ReneSpanl/GridFrequency/PCB/IsolationBarrier/Anlage/BotView.png

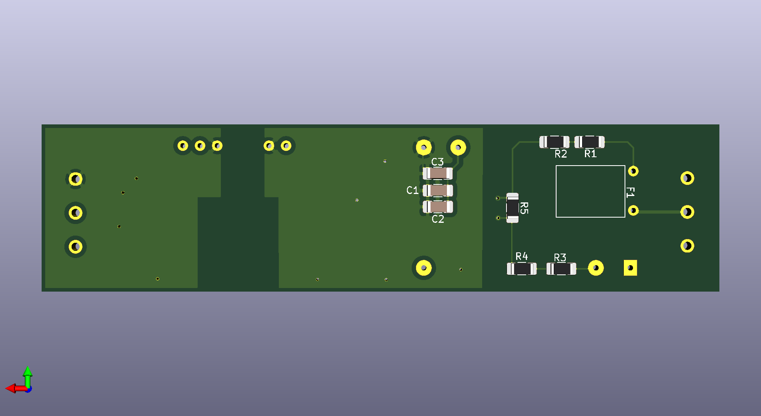
PCB/IsolationBarrier/Anlage/BotView.png
