ReneSpanl/GridFrequency/PCB/IsolationBarrier/Anlage/TopView.png

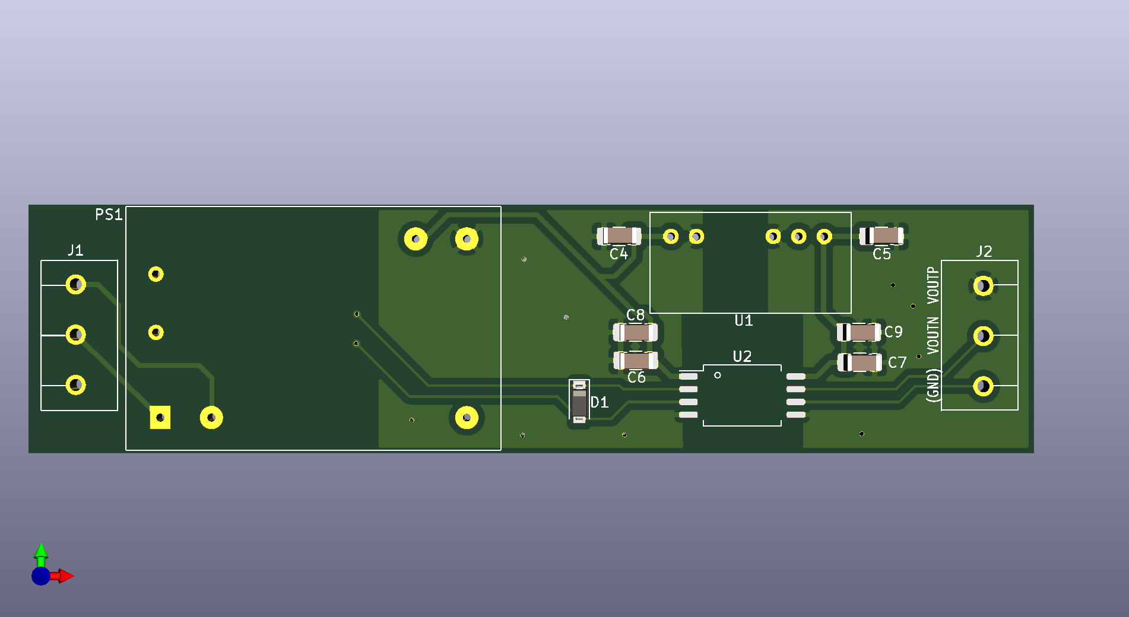
PCB/IsolationBarrier/Anlage/TopView.png
