ReneSpanl/GridFrequency/Messwerterfassung_Messproblem_DT9816.pdf

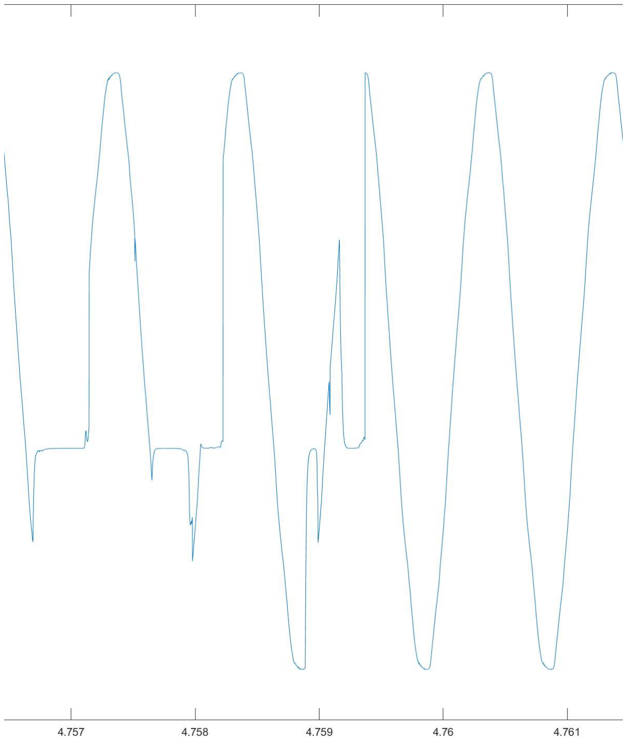
[picture p3: page 1]
