ReneSpanl/GridFrequency/PCB/PCB.csv

Reference | Quantity | Value | Footprint | Datasheet
AE1 | 1 | SMB Antenna | Frequenzmessung PCB:Molex_SMB_0731000103 | https://www.digikey.de/product-detail/de/molex/0731000103/WM5523-ND/1465145
C1 C7 C8 C18 C17 C30 C25 C36 C40 | 9 | 100nF | Capacitor_SMD:C_1206_3216Metric_Pad1.42x1.75mm_HandSolder | https://www.digikey.de/product-detail/de/samsung-electro-mechanics/CL31B104KBCNFNC/1276-2744-1-ND/3890830
C11 C19 C15 C2 C37 | 5 | 10nF | Capacitor_SMD:C_1206_3216Metric_Pad1.42x1.75mm_HandSolder | https://www.digikey.de/product-detail/de/samsung-electro-mechanics/CL31B103KBCNNNC/1276-1035-1-ND/3889121
C13 | 1 | 11nF | Capacitor_SMD:C_1206_3216Metric_Pad1.42x1.75mm_HandSolder | https://www.digikey.de/product-detail/de/murata-electronics/GRM3195C1H113JA01D/490-1755-1-ND/587572
C16 | 1 | 20.5nF | Capacitor_SMD:C_1206_3216Metric_Pad1.42x1.75mm_HandSolder | https://www.digikey.de/product-detail/de/murata-electronics/GRM3195C1H203JA01D/490-1760-1-ND/587546
C22 | 1 | 154nF | Capacitor_SMD:C_1206_3216Metric_Pad1.42x1.75mm_HandSolder | https://www.digikey.de/product-detail/de/yageo/CC1206JKX7R9BB154/311-4385-1-ND/8025474
C3 C14 | 2 | 2200uF | Capacitor_SMD:CP_Elec_10x10.5 | https://www.digikey.de/product-detail/de/panasonic-electronic-components/EEE-FT1A152AP/P15083CT-ND/2796924
C4 C12 | 2 | 100uF | Capacitor_SMD:C_1206_3216Metric_Pad1.42x1.75mm_HandSolder | https://www.digikey.de/product-detail/de/taiyo-yuden/JMK316ABJ107ML-T/587-3395-1-ND/4157508
C5 C10 C29 C23 C27 C24 C34 C38 C32 C31 | 10 | 10uF | Capacitor_SMD:C_1206_3216Metric_Pad1.42x1.75mm_HandSolder | https://www.digikey.de/product-detail/de/samsung-electro-mechanics/CL21A106KOQNNWE/1276-2894-1-ND/3890980
C6 C9 C21 C20 C26 C28 C35 C39 C33 | 9 | 1uF | Capacitor_SMD:C_1206_3216Metric_Pad1.42x1.75mm_HandSolder | https://www.digikey.de/product-detail/de/samsung-electro-mechanics/CL31B105KAHNNNE/1276-1097-1-ND/3889183
D2 D1 | 2 | 5V | Diode_SMD:D_SOD-323_HandSoldering | https://www.digikey.de/product-detail/de/diodes-incorporated/MMSZ5232BS-7-F/MMSZ5232BS-FDICT-ND/815868
J1 | 1 | USB_B_Micro | DigiKey Footprints:USB_Micro_B_Female_10118194-0001LF | https://www.digikey.de/product-detail/de/amphenol-icc-fci/10118194-0001LF/609-4618-2-ND/2785389
J2 | 1 | 6P6C | Frequenzmessung PCB:6P6C | https://www.digikey.de/product-detail/de/pulse-electronics-network/E5566-Q0LK22-L/553-2258-ND/1785239
J3 | 1 | Raspberry_Pi_2_3 | Connector_PinSocket_2.54mm:PinSocket_2x20_P2.54mm_Vertical | https://www.digikey.de/product-detail/de/samtec-inc/ESQ-120-23-T-D/SAM9315-ND/6678052
L1 | 1 | 27nH | Inductor_SMD:L_1206_3216Metric_Pad1.42x1.75mm_HandSolder | https://www.digikey.de/product-detail/de/tdk-corporation/NLV32T-027J-EF/445-16534-1-ND/4766575
R1 R2 | 2 | 27 | Resistor_SMD:R_1206_3216Metric_Pad1.42x1.75mm_HandSolder | https://www.digikey.de/product-detail/de/stackpole-electronics-inc/RMCF1206JT27R0/RMCF1206JT27R0CT-ND/2418899
R10 | 1 | 5.9k | Resistor_SMD:R_1206_3216Metric_Pad1.42x1.75mm_HandSolder | https://www.digikey.de/product-detail/de/koa-speer-electronics-inc/RK73H2BTTD5901F/2019-RK73H2BTTD5901FCT-ND/10237182
R11 | 1 | 3.16k | Resistor_SMD:R_1206_3216Metric_Pad1.42x1.75mm_HandSolder | https://www.digikey.de/product-detail/de/rohm-semiconductor/MCR18ERTF3161/RHM3-16KCJCT-ND/4085566
R13 | 1 | 1.13k | Resistor_SMD:R_1206_3216Metric_Pad1.42x1.75mm_HandSolder | https://www.digikey.de/product-detail/de/rohm-semiconductor/MCR18ERTF1131/RHM1-13KCJCT-ND/4085288
R14 | 1 | 1.62k | Resistor_SMD:R_1206_3216Metric_Pad1.42x1.75mm_HandSolder | https://www.digikey.de/product-detail/de/stackpole-electronics-inc/RMCF1206FT1K62/RMCF1206FT1K62CT-ND/2418617
R17 R16 | 2 | 390k | Resistor_SMD:R_1206_3216Metric_Pad1.42x1.75mm_HandSolder | https://www.digikey.de/product-detail/de/stackpole-electronics-inc/RMCF1206FT390K/RMCF1206FT390KCT-ND/2418725
R18 R15 | 2 | 52.3k | Resistor_SMD:R_1206_3216Metric_Pad1.42x1.75mm_HandSolder | https://www.digikey.de/product-detail/de/koa-speer-electronics-inc/RK73H2BTTD5232F/2019-RK73H2BTTD5232FCT-ND/10237717
R19 | 1 | 1k | Resistor_SMD:R_1206_3216Metric_Pad1.42x1.75mm_HandSolder | https://www.digikey.de/product-detail/de/stackpole-electronics-inc/RMCF1206JT1K00/RMCF1206JT1K00CT-ND/1942786
R20 | 1 | 0 | Resistor_SMD:R_1206_3216Metric_Pad1.42x1.75mm_HandSolder | https://www.digikey.de/product-detail/de/stackpole-electronics-inc/RMCF1206ZT0R00/RMCF1206ZT0R00CT-ND/1942835
R3 R21 | 2 | 10k | Resistor_SMD:R_1206_3216Metric_Pad1.42x1.75mm_HandSolder | https://www.digikey.de/product-detail/de/stackpole-electronics-inc/RMCF1206JT10K0/RMCF1206JT10K0CT-ND/1942803
R4 | 1 | 10 | Resistor_SMD:R_1206_3216Metric_Pad1.42x1.75mm_HandSolder | https://www.digikey.de/product-detail/de/stackpole-electronics-inc/RMCF1206JG10R0/RMCF1206JG10R0CT-ND/6053279
R5 R6 | 2 | 5k | Resistor_SMD:R_1206_3216Metric_Pad1.42x1.75mm_HandSolder | https://www.digikey.de/product-detail/de/yageo/RT1206BRD075KL/YAG5090CT-ND/6617246
R8 R12 | 2 | 4.32k | Resistor_SMD:R_1206_3216Metric_Pad1.42x1.75mm_HandSolder | https://www.digikey.de/product-detail/de/stackpole-electronics-inc/RMCF1206FT4K32/RMCF1206FT4K32CT-ND/1942695
R9 R7 | 2 | 22.5k | Resistor_SMD:R_1206_3216Metric_Pad1.42x1.75mm_HandSolder | https://www.digikey.de/product-detail/de/koa-speer-electronics-inc/RK73H2BTTD2262F/2019-RK73H2BTTD2262FCT-ND/10237879
SW1 | 1 | SW_DIP_x01 | Button_Switch_SMD:SW_DIP_SPSTx01_Slide_9.78x4.72mm_W8.61mm_P2.54mm | https://www.digikey.de/product-detail/de/cui-devices/DS04-254-1-01BK-SMT/2223-DS04-254-1-01BK-SMT-ND/11310893
TP2 TP1 TP7 TP6 TP8 TP9 TP4 TP3 TP5 | 9 | TestPoint | Connector_PinHeader_2.54mm:PinHeader_1x01_P2.54mm_Vertical | schon vorhanden
U1 | 1 | NEO-M8M | RF_GPS:ublox_NEO | schon vorhanden
U2 | 1 | LM2902 | Frequenzmessung PCB:LM2902_14_pin | schon vorhanden
U3 | 1 | LTC3265 | Frequenzmessung PCB:LTC3265 | schon vorhanden
U4 | 1 | ADS868X | Package_SO:SSOP-16_4.4x5.2mm_P0.65mm | schon vorhanden
