ReneSpanl/GridFrequency/PCB/BOM.xlsx

Für Peripherie
1x | Solderpaste |  | https://www.digikey.de/product-detail/de/chip-quik-inc/SMD291AX50T3/SMD291AX50T3-ND/5130159
1x | Raspberry Pi 4 |  | https://www.reichelt.de/raspberry-pi-4-b-4x-1-5-ghz-2-gb-ram-wlan-bt-rasp-pi-4-b-2gb-p259919.html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
1x | Netzteil usb c |  | https://www.reichelt.de/raspberry-pi-netzteil-5-1-v-3-0-a-usb-type-c-eu-stecker-s-rpi-ps-15w-bk-eu-p260010.html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
1x | microHDMI zu HDMI |  | https://www.reichelt.de/raspberry-pi-adapter-micro-hdmi-auf-hdmi-2m-schwarz-rpi-m-hdmi-hdmi4-p275440.html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
1x | MicroSD |  | https://www.reichelt.de/microsdxc-speicherkarte-128gb-sandisk-extreme-pro-sdsqxcy128ggn6ma-p262419.html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
1x | ESD Bürste |  | https://www.reichelt.de/esd-reinigungsbuerste-pinsel-6-7-cm-quad-1903ec075-p292923.html?trstct=pos_11&nbc=1
1x | Glasfaserradierer |  | https://www.reichelt.de/sg/de/glasradierer-glasfaserpinsel-radierer-glas-p53404.html?trstct=pos_0&nbc=1
Bauelemente:
Analog front end |  |  |  | IsolationsPCB
5x | 6P6C Conn. | https://www.digikey.de/product-detail/de/pulse-electronics-network/E5566-Q0LK22-L/553-2258-ND/1785239 |  | 10x | 22uF | https://www.digikey.de/product-detail/de/samsung-electro-mechanics/CL31A226MOCLNNC/1276-2728-1-ND/3890814
2x | Pi 40Pin | https://www.digikey.de/product-detail/de/samtec-inc/ESQ-120-23-T-D/SAM9315-ND/6678052 |  | 50x | 100nF | https://www.digikey.de/product-detail/de/samsung-electro-mechanics/CL31B104KBCNFNC/1276-2744-1-ND/3890830
2x | SMB | https://www.digikey.de/product-detail/de/molex/0731000103/WM5523-ND/1465145 |  | 20x | 1uF | https://www.digikey.de/product-detail/de/samsung-electro-mechanics/CL31B105KAHNNNE/1276-1097-1-ND/3889183
50x | 100nF | https://www.digikey.de/product-detail/de/samsung-electro-mechanics/CL31B104KBCNFNC/1276-2744-1-ND/3890830 |  | 20x | 10u | https://www.digikey.de/product-detail/de/samsung-electro-mechanics/CL31B106KAHNNNE/1276-1804-1-ND/3889890
50x | 10nF | https://www.digikey.de/product-detail/de/samsung-electro-mechanics/CL31B103KBCNNNC/1276-1035-1-ND/3889121 |  | 10x | TVS | https://www.digikey.de/product-detail/de/rohm-semiconductor/RSA5MGTR/846-RSA5MGCT-ND/2331732
10x | 11nF | https://www.digikey.de/product-detail/de/murata-electronics/GRM3195C1H113JA01D/490-1755-1-ND/587572 |  | 5x | Fuse | https://www.digikey.de/product-detail/de/littelfuse-inc/LVR005NS/LVR005NS-ND/1853845
10x | 20.5nF | https://www.digikey.de/product-detail/de/murata-electronics/GRM3195C1H203JA01D/490-1760-1-ND/587546 |  | 5x | IEC Conn. | https://www.digikey.de/product-detail/de/schurter-inc/4300-0103/486-4132-ND/8299834
10x | 154nF | https://www.digikey.de/product-detail/de/yageo/CC1206JKX7R9BB154/311-4385-1-ND/8025474 |  | 5x | 6P6C Conn. | https://www.digikey.de/product-detail/de/pulse-electronics-network/E5566-Q0LK22-L/553-2258-ND/1785239
10x | 1500uF | https://www.digikey.de/product-detail/de/panasonic-electronic-components/EEE-FT1A152AP/P15083CT-ND/2796924 |  | 100x | 82k R | https://www.digikey.de/product-detail/de/te-connectivity-passive-product/CRGP1206F82K/A130561CT-ND/8578393
20x | 100uF | https://www.digikey.de/product-detail/de/taiyo-yuden/JMK316ABJ107ML-T/587-3395-1-ND/4157508 |  | 10x | 200 R | https://www.digikey.de/product-detail/de/panasonic-electronic-components/ERA-8AEB201V/P200BCCT-ND/3069644
100x | 10uF | https://www.digikey.de/product-detail/de/samsung-electro-mechanics/CL21A106KOQNNWE/1276-2894-1-ND/3890980 |  | 100x | 8,2k R | https://www.digikey.de/product-detail/de/koa-speer-electronics-inc/RK73H2BTTD8201F/2019-RK73H2BTTD8201FCT-ND/10237915
100x | 1uF | https://www.digikey.de/product-detail/de/samsung-electro-mechanics/CL31B105KAHNNNE/1276-1097-1-ND/3889183 |  | 1x | Epoxy?? | https://www.reichelt.de/sg/de/polyurethan-giessharz-natur-500-g-pure-st22-nat-p145528.html?trstct=pos_1&nbc=1
10x | TVS 5V | https://www.digikey.de/product-detail/de/diodes-incorporated/MMSZ5232BS-7-F/MMSZ5232BS-FDICT-ND/815868
5x | USB Conn. | https://www.digikey.de/product-detail/de/amphenol-icc-fci/10118194-0001LF/609-4618-1-ND/2785382
5x | 27nH | https://www.digikey.de/product-detail/de/tdk-corporation/NLV32T-027J-EF/445-16534-1-ND/4766575 |  | Leistungsschalter
20x | 27Ohm | https://www.digikey.de/product-detail/de/stackpole-electronics-inc/RMCF1206JT27R0/RMCF1206JT27R0CT-ND/2418899
10x | 5.9kOhm | https://www.digikey.de/product-detail/de/koa-speer-electronics-inc/RK73H2BTTD5901F/2019-RK73H2BTTD5901FCT-ND/10237182 |  | 25x | Sockel | https://www.digikey.de/product-detail/de/on-shore-technology-inc/ED14DT/ED3045-5-ND/4147595
10x | 3.16kOhm | https://www.digikey.de/product-detail/de/rohm-semiconductor/MCR18ERTF3161/RHM3-16KCJCT-ND/4085566
10x | 1.13kOhm | https://www.digikey.de/product-detail/de/rohm-semiconductor/MCR18ERTF1131/RHM1-13KCJCT-ND/4085288 |  | 5x | IC XOR | https://www.digikey.de/product-detail/de/texas-instruments/SN74HC86N/296-8375-5-ND/376842
10x | 1.62kOhm | https://www.digikey.de/product-detail/de/stackpole-electronics-inc/RMCF1206FT1K62/RMCF1206FT1K62CT-ND/2418617 |  | 5x | IC NOT | https://www.digikey.de/product-detail/de/texas-instruments/SN74HC04N/296-1566-5-ND/277212
20x | 390kOhm | https://www.digikey.de/product-detail/de/stackpole-electronics-inc/RMCF1206FT390K/RMCF1206FT390KCT-ND/2418725 |  | 5x | IC OPEN COLL | https://www.digikey.de/product-detail/de/texas-instruments/SN74LS07N/296-14878-5-ND/563054
20x | 52.3kOhm | https://www.digikey.de/product-detail/de/koa-speer-electronics-inc/RK73H2BTTD5232F/2019-RK73H2BTTD5232FCT-ND/10237717 |  | 10x | DIODE | https://www.digikey.de/product-detail/de/comchip-technology/1N4007-G/641-1312-1-ND/1979677
10x | 1kOhm | https://www.digikey.de/product-detail/de/stackpole-electronics-inc/RMCF1206JT1K00/RMCF1206JT1K00CT-ND/1942786
30x | 0Ohm | https://www.digikey.de/product-detail/de/stackpole-electronics-inc/RMCF1206ZT0R00/RMCF1206ZT0R00CT-ND/1942835
20x | 10kOhm | https://www.digikey.de/product-detail/de/stackpole-electronics-inc/RMCF1206JT10K0/RMCF1206JT10K0CT-ND/1942803
20x | 10Ohm | https://www.digikey.de/product-detail/de/stackpole-electronics-inc/RMCF1206JG10R0/RMCF1206JG10R0CT-ND/6053279
30x | 5kOhm | https://www.digikey.de/product-detail/de/yageo/RT1206BRD075KL/YAG5090CT-ND/6617246
20x | 4.32kOhm | https://www.digikey.de/product-detail/de/stackpole-electronics-inc/RMCF1206FT4K32/RMCF1206FT4K32CT-ND/1942695
20x | 22kOhm | https://www.digikey.de/product-detail/de/yageo/RT1206BRD0722KL/YAG2027CT-ND/5139475
5x | SWITCH | https://www.digikey.de/product-detail/de/cui-devices/DS04-254-1-01BK-SMT/2223-DS04-254-1-01BK-SMT-ND/11310893
2x | NEO-M8 | https://www.digikey.de/product-detail/de/u-blox/NEO-M8M-0/672-NEO-M8M-0CT-ND/6150670
1x | Antenne | https://www.digikey.de/product-detail/de/u-blox/ANN-MS-1/672-ANN-MS-1-ND/9817932
5x | 27nH | https://www.digikey.de/product-detail/de/w%C3%BCrth-elektronik/744762127A/732-1813-1-ND/1994393
