ReneSpanl/GridFrequency/PCB/PCB.pdf

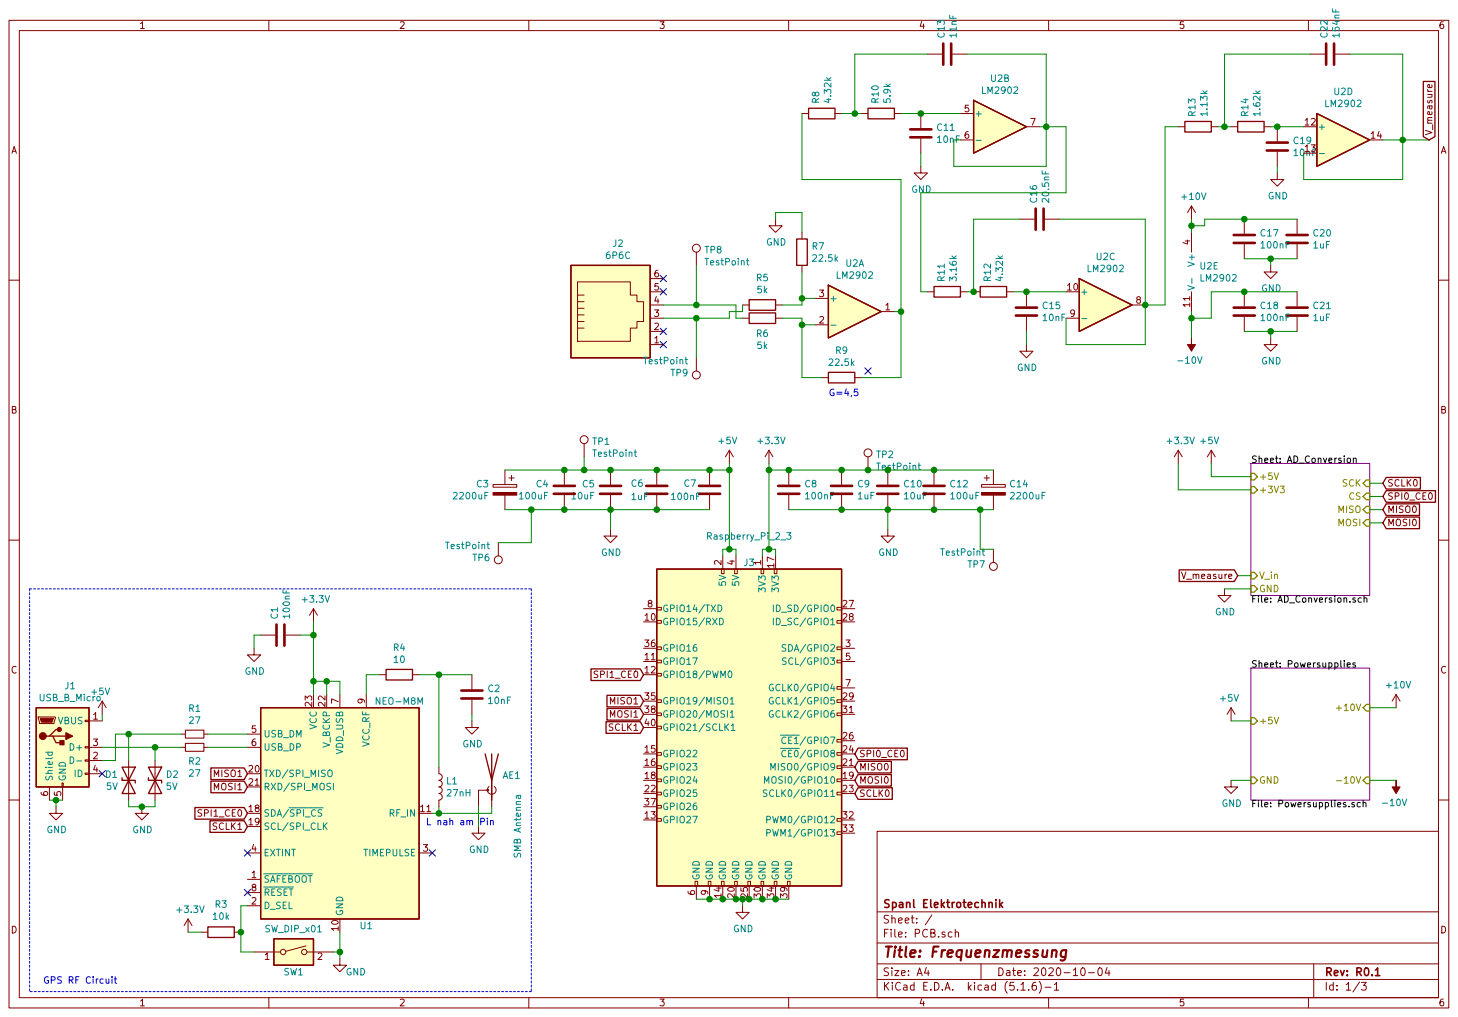
[picture p4: page 1]

Sheet: AD_Conversion File: AD_Conversion.sch V_in GND

File: PCB.sch Sheet: / Spanl Elektrotechnik

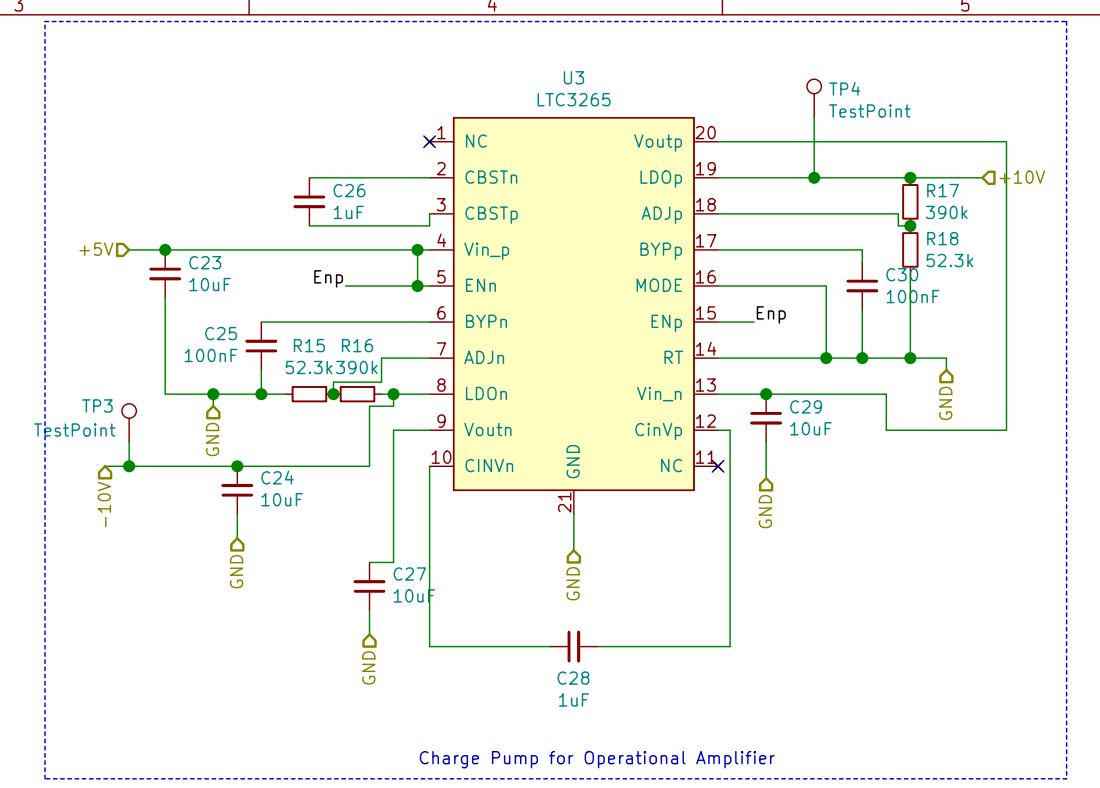
[picture p5: page 2]

Charge Pump for Operational Amplifier

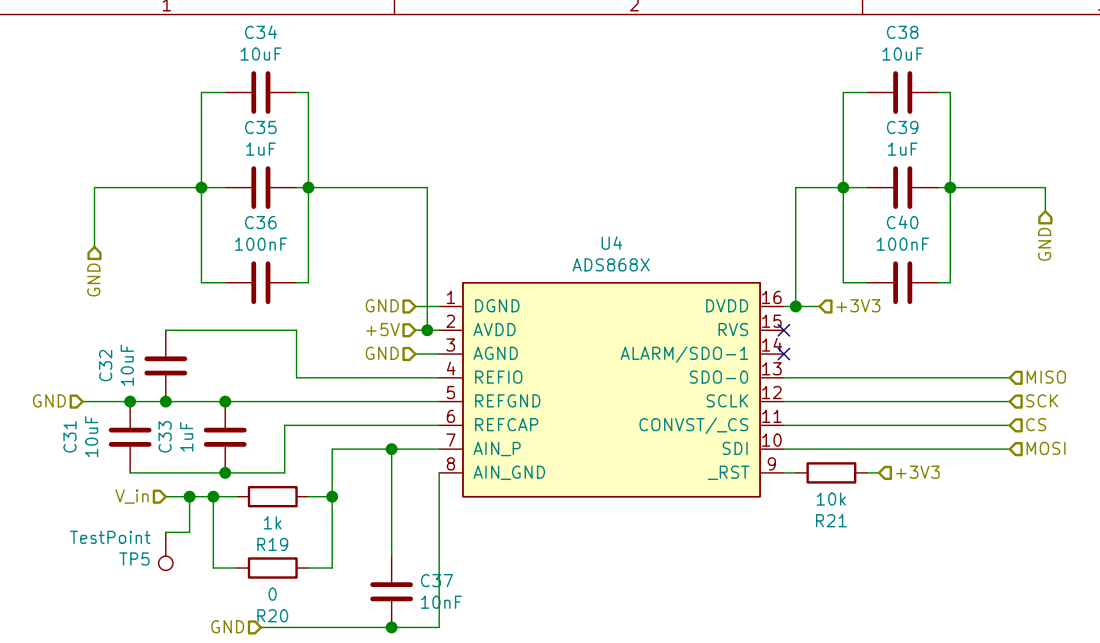
[picture p6: page 3]
