ReneSpanl/GridFrequency/50Hz Oberschwingungen.pdf

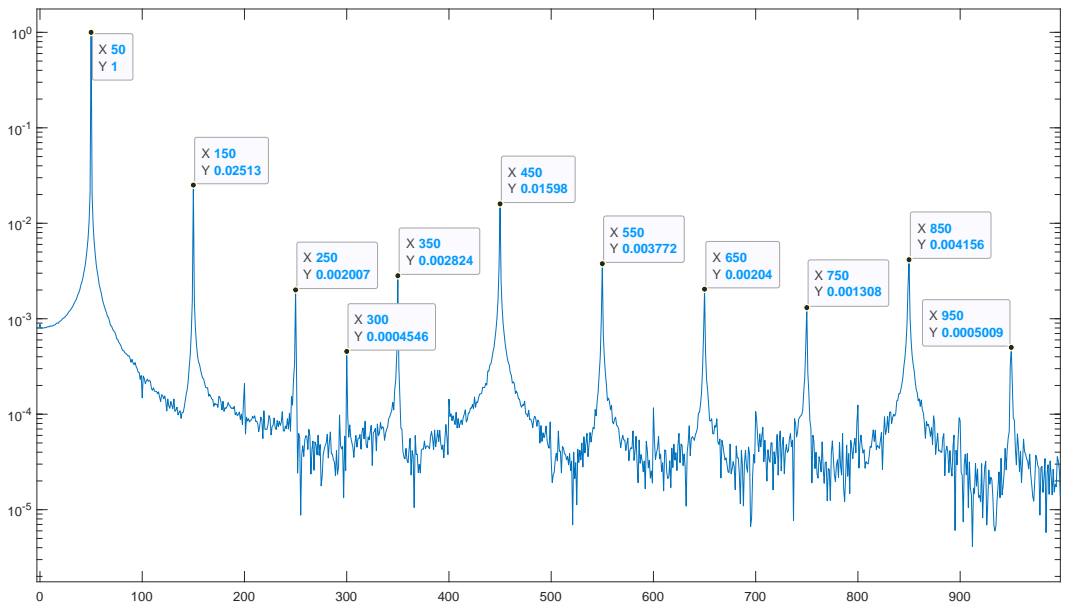
[picture p7: page 1]
