ReneSpanl/GridFrequency/PCB/IsolationBarrier/Anlage/Schaltplan.pdf

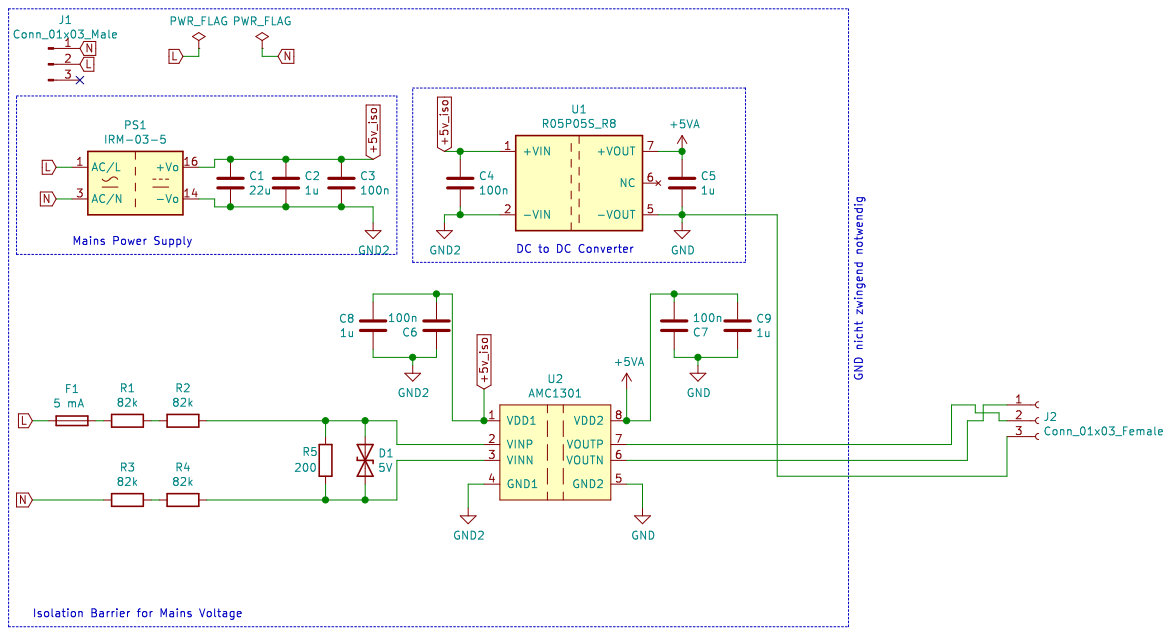
[picture p8: page 1]
