ReneSpanl/GridFrequency/LTSpice Filter Simulation/6thOrderButterworth.asc

C1: cap; 10n
C2: cap; 11n
C7: cap; 10n
C8: cap; 20.5n
C9: cap; 10n
C10: cap; 154n
R1: res; 4.32k
R2: res; 5.9k
R3: res; 1.13k
R6: res; 3.16k
R7: res; 4.32k
R8: res; 1.62k
U1: UniversalOpamp2
U2: UniversalOpamp2
U4: UniversalOpamp2
V1: voltage; ""; AC 1 0
V2: voltage; 10
V3: voltage; 10
Named nets: 0, U_out, +10, -10
.ac lin 100000 1 10k
.lib opamp.sub
3k Butterworth
