ReneSpanl/GridFrequency/PCB/PCB.kicad_pcb

## KiCad design PCB/PCB.kicad_pcb (2021-05-28)

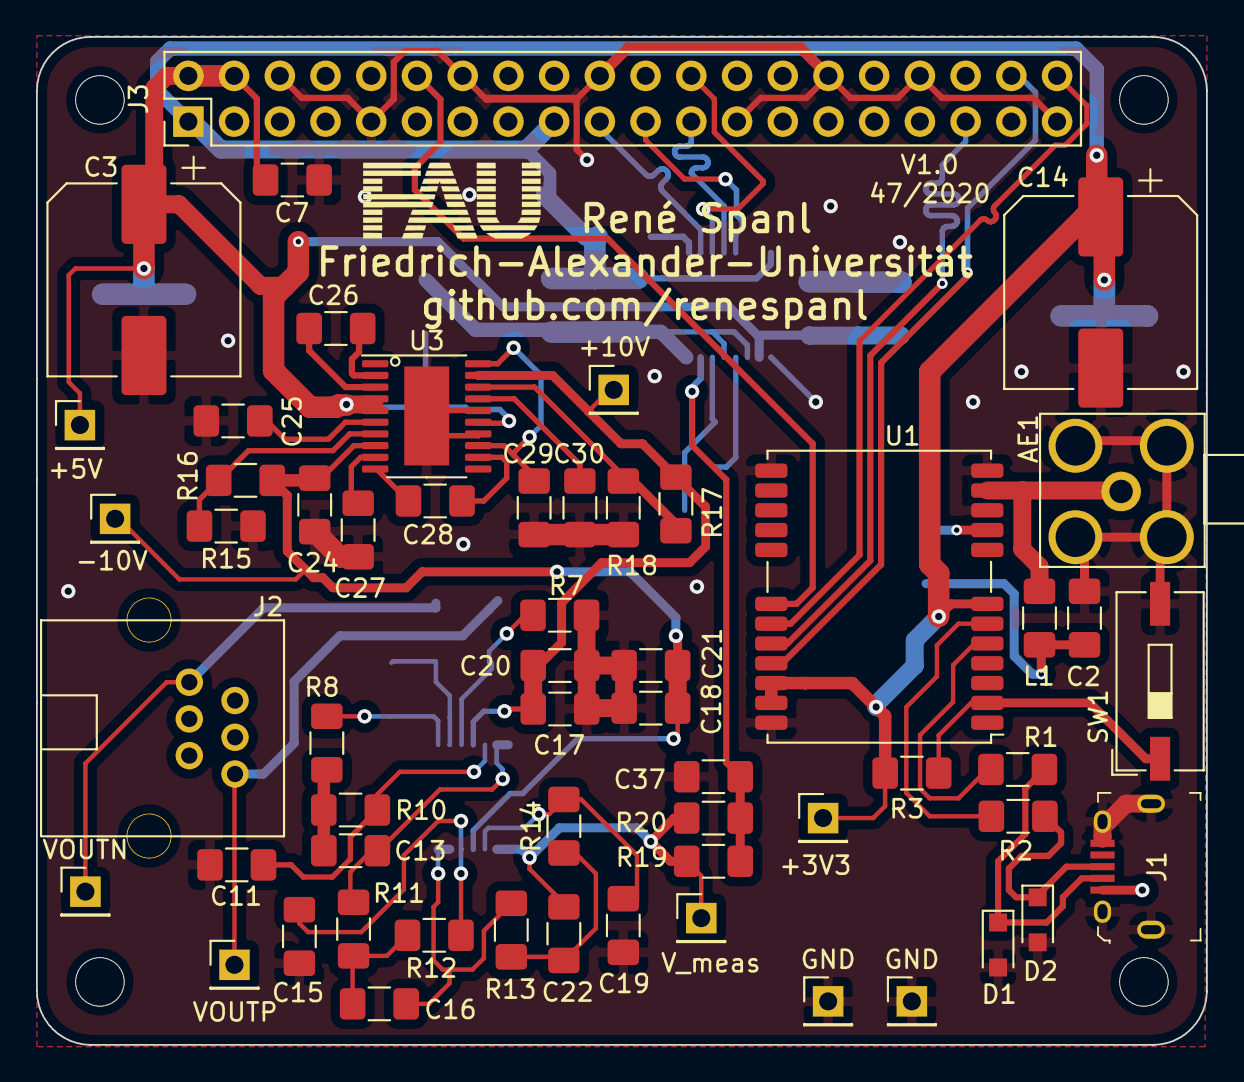
[picture p9: board PCB.kicad_pcb from above]

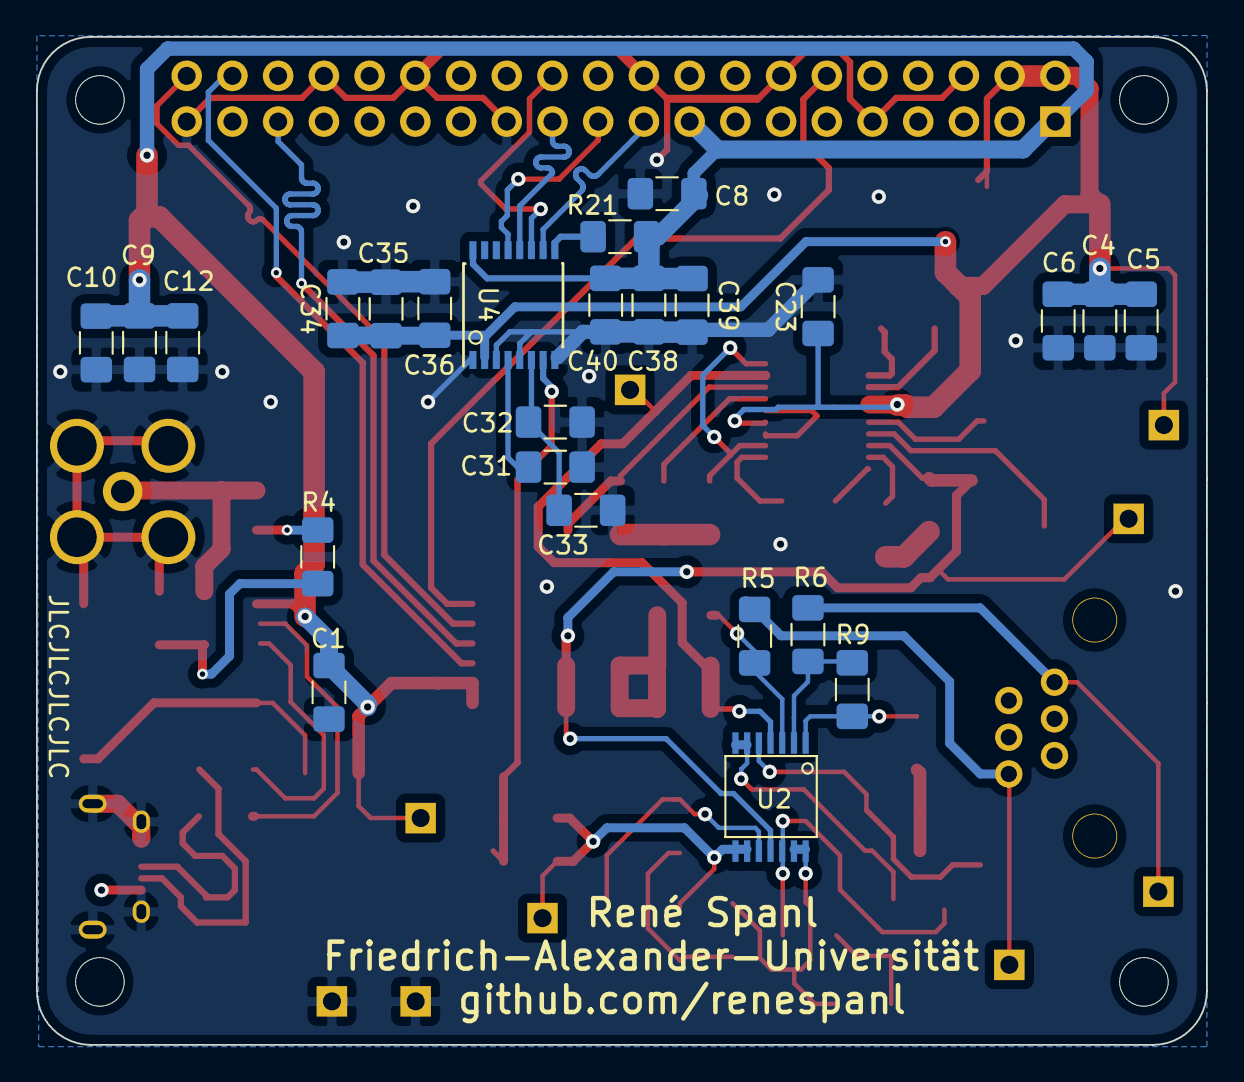
[picture p10: board PCB.kicad_pcb from below]

Board: 2 copper layers, 65.0 x 56.0 mm, 86 parts (25 on the bottom side), 49 nets.

Parts:
+3V3, +5V, +10V: TestPoint; PinHeader_1x01_P2.54mm_Vertical
-10V: TestPoint; PinHeader_1x01_P2.54mm_Vertical
AE1: SMB Antenna; Molex_SMB_0731000103
C1, C7, C8, C17, C18, C30, C36, C40: 100n; C_1206_3216Metric_Pad1.42x1.75mm_HandSolder
C2, C11, C15, C19, C37: 10n; C_1206_3216Metric_Pad1.42x1.75mm_HandSolder
C3, C14: 2200u; CP_Elec_10x10.5
C4, C12: 100u; C_1206_3216Metric_Pad1.42x1.75mm_HandSolder
C5, C10, C31, C32, C34, C38: 10u; C_1206_3216Metric_Pad1.42x1.75mm_HandSolder
C6, C9, C20, C21, C33, C35, C39: 1u; C_1206_3216Metric_Pad1.42x1.75mm_HandSolder
C13: 11n; C_1206_3216Metric_Pad1.42x1.75mm_HandSolder
C16: 20.5n; C_1206_3216Metric_Pad1.42x1.75mm_HandSolder
C22: 154n; C_1206_3216Metric_Pad1.42x1.75mm_HandSolder
C23, C24, C27, C29: 10uF; C_1206_3216Metric_Pad1.42x1.75mm_HandSolder
C25: 100nF; C_1206_3216Metric_Pad1.42x1.75mm_HandSolder
C26, C28: 1uF; C_1206_3216Metric_Pad1.42x1.75mm_HandSolder
D1, D2: 5V; D_SOD-323_HandSoldering
GND: TestPoint; PinHeader_1x01_P2.54mm_Vertical
GND#2: TestPoint; PinHeader_1x01_P2.54mm_Vertical
J1: USB_B_Micro; USB_Micro_B_Female_10118194-0001LF
J2: 6P6C
J3: Raspberry_Pi_2_3; PinSocket_2x20_P2.54mm_Vertical
L1: 27n; L_1206_3216Metric_Pad1.42x1.75mm_HandSolder
MK1, MK2, MK3, MK4: M2.5; MountingHole_2.7mm_M2.5
R1, R2: 27; R_1206_3216Metric_Pad1.42x1.75mm_HandSolder
R3, R21: 10k; R_1206_3216Metric_Pad1.42x1.75mm_HandSolder
R4: 10; R_1206_3216Metric_Pad1.42x1.75mm_HandSolder
R5, R6: 5k; R_1206_3216Metric_Pad1.42x1.75mm_HandSolder
R7, R9: 22.5k; R_1206_3216Metric_Pad1.42x1.75mm_HandSolder
R8, R12: 4.32k; R_1206_3216Metric_Pad1.42x1.75mm_HandSolder
R10: 5.9k; R_1206_3216Metric_Pad1.42x1.75mm_HandSolder
R11: 3.16k; R_1206_3216Metric_Pad1.42x1.75mm_HandSolder
R13: 1.13k; R_1206_3216Metric_Pad1.42x1.75mm_HandSolder
R14: 1.62k; R_1206_3216Metric_Pad1.42x1.75mm_HandSolder
R15, R18: 52.3k; R_1206_3216Metric_Pad1.42x1.75mm_HandSolder
R16, R17: 390k; R_1206_3216Metric_Pad1.42x1.75mm_HandSolder
R19: 1k; R_1206_3216Metric_Pad1.42x1.75mm_HandSolder
R20: 0; R_1206_3216Metric_Pad1.42x1.75mm_HandSolder
SW1: SW_DIP_x01; SW_DIP_SPSTx01_Slide_9.78x4.72mm_W8.61mm_P2.54mm
U1: NEO-M8M; ublox_NEO
U2: LM2902; LM2902_14_pin
U3: LTC3265
U4: ADS868X; SSOP-16_4.4x5.2mm_P0.65mm
VOUTN: TestPoint; PinHeader_1x01_P2.54mm_Vertical
VOUTP: TestPoint; PinHeader_1x01_P2.54mm_Vertical
V_meas: TestPoint; PinHeader_1x01_P2.54mm_Vertical

Connections:
+3V3: +3V3.1, C1.2, C8.1, C9.1, C10.1, C12.1, C14.1, C38.2, C39.2, C40.2, J3.1, J3.17, R3.1, R21.2, U1.7, U1.22, U1.23, U4.16
+5V: +5V.1, C3.1, C4.1, C5.1, C6.1, C7.1, C23.1, C34.1, C35.1, C36.1, J3.2, J3.4, U3.4, U3.5, U3.15, U4.2
+10V: +10V.1, C17.1, C20.1, R17.1, U2.4, U3.19
-10V: -10V.1, C18.1, C21.1, C24.2, R16.2, U2.11, U3.8
GND: AE1.2, C1.1, C2.2, C3.2, C4.2, C5.2, C6.2, C7.2, C8.2, C9.2, C10.2, C11.2, C12.2, C14.2, C15.2, C17.2, C18.2, C19.2, C20.2, C21.2, C23.2, C24.1, C25.1, C27.1, C29.2, C30.2, C31.1, C32.2, C33.1, C34.2, C35.2, C36.2, C37.2, C38.1, C39.1, C40.1, D1.2, D2.2, GND.1, GND#2.1, J1.5, J1.6, J3.6, J3.9, J3.14, J3.20, J3.25, J3.30, J3.34, J3.39, R7.1, R15.1, R18.2, SW1.2, U1.10, U1.12, U1.13, U1.24, U3.14, U3.16, U3.21, U4.1, U4.3, U4.5, U4.8
MISO0: J3.21, U4.13
MISO1: J3.35, U1.20
MOSI0: J3.19, U4.10
MOSI1: J3.38, U1.21
unnamed: AE1.1, L1.2, U1.11
unnamed: C2.1, L1.1, R4.1
unnamed: C11.1, R10.2, U2.5
unnamed: C13.1, R8.2, R10.1
unnamed: C13.2, R11.1, U2.6, U2.7
unnamed: C15.1, R12.2, U2.10
unnamed: C16.1, R11.2, R12.1
unnamed: C16.2, R13.1, U2.8, U2.9
unnamed: C19.1, R14.2, U2.12
unnamed: C22.1, R13.2, R14.1
unnamed: C25.2, U3.6
unnamed: C26.1, U3.2
unnamed: C26.2, U3.3
unnamed: C27.2, U3.9
unnamed: C28.1, U3.10
unnamed: C28.2, U3.12
unnamed: C29.1, U3.13, U3.20
unnamed: C30.1, U3.17
unnamed: C31.2, C33.2, U4.6
unnamed: C32.1, U4.4
unnamed: C37.1, R19.2, R20.2, U4.7
unnamed: D1.1, J1.2, R1.2
unnamed: D2.1, J1.3, R2.2
unnamed: J2.3, R5.2, VOUTP.1
unnamed: J2.4, R6.2, VOUTN.1
unnamed: R1.1, U1.5
unnamed: R2.1, U1.6
unnamed: R3.2, SW1.1, U1.2
unnamed: R4.2, U1.9
unnamed: R5.1, R7.2, U2.3
unnamed: R6.1, R9.2, U2.2
unnamed: R8.1, R9.1, U2.1
unnamed: R15.2, R16.1, U3.7
unnamed: R17.2, R18.1, U3.18
unnamed: R21.1, U4.9
SCLK0: J3.23, U4.12
SCLK1: J3.40, U1.19
SPI0_CE0: J3.24, U4.11
SPI1_CE0: J3.12, U1.18
V_measure: C22.2, R19.1, R20.1, U2.13, U2.14, V_meas.1
