ReneSpanl/GridFrequency/PCB/IsolationBarrier/IsolationBarrier.kicad_pcb

## KiCad design PCB/IsolationBarrier/IsolationBarrier.kicad_pcb (2021-05-28)

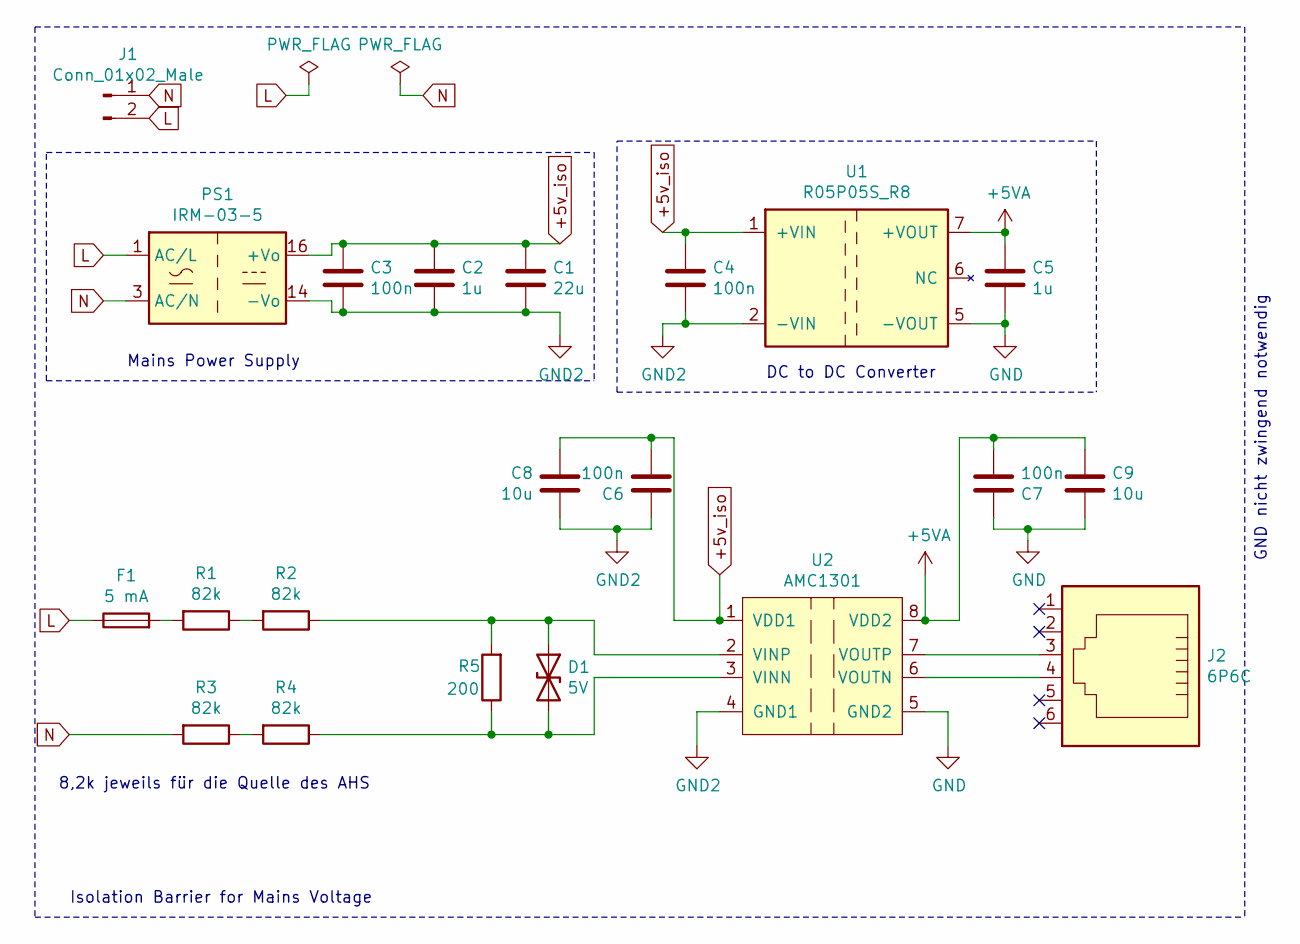
[picture p11: schematic IsolationBarrier.sch]

Parts:
C1: 22u; C_1206_3216Metric_Pad1.42x1.75mm_HandSolder
C2, C5: 1u; C_1206_3216Metric_Pad1.42x1.75mm_HandSolder
C3, C4, C6, C7: 100n; C_1206_3216Metric_Pad1.42x1.75mm_HandSolder
C8, C9: 10u; C_1206_3216Metric_Pad1.42x1.75mm_HandSolder
D1: 5V; D_SOD-123
F1: 5 mA; LVR005NS
J1: Conn_01x02_Male; IEC_C8_PCB_Connector
J2: 6P6C
PS1: IRM-03-5; Converter_ACDC_MeanWell_IRM-03-xx_THT
R1, R2, R3, R4: 82k; R_1206_3216Metric_Pad1.42x1.75mm_HandSolder
R5: 200; R_1206_3216Metric_Pad1.42x1.75mm_HandSolder
U1: R05P05S_R8; RECOM-R05P05S
U2: AMC1301; SOIC-8_7.5x5.85mm_P1.27mm

Connections:
+5VA: C5.1, C7.2, C9.1, U1.7 (+VOUT), U2.8 (VDD2)
+5v_iso: C1.1, C2.1, C3.1, C4.1, C6.2, C8.1, PS1.16 (+Vo), U1.1 (+VIN), U2.1 (VDD1)
GND: C5.2, C7.1, C9.2, U1.5 (-VOUT), U2.5 (GND2)
GND2: C1.2, C2.2, C3.2, C4.2, C6.1, C8.2, PS1.14 (-Vo), U1.2 (-VIN), U2.4 (GND1)
L: F1.1, J1.2, PS1.1 (AC/L)
N: J1.1, PS1.3 (AC/N), R3.2
unnamed: D1.1 (A1), R2.1, R5.2, U2.2 (VINP)
unnamed: D1.2 (A2), R4.1, R5.1, U2.3 (VINN)
unnamed: F1.2, R1.2
unnamed: J2.3, U2.7 (VOUTP)
unnamed: J2.4, U2.6 (VOUTN)
unnamed: R1.1, R2.2
unnamed: R3.1, R4.2

Notes on the sheet:
Isolation Barrier for Mains Voltage
Mains Power Supply
GND nicht zwingend notwendig
DC to DC Converter
8,2k jeweils für die Quelle des AHS

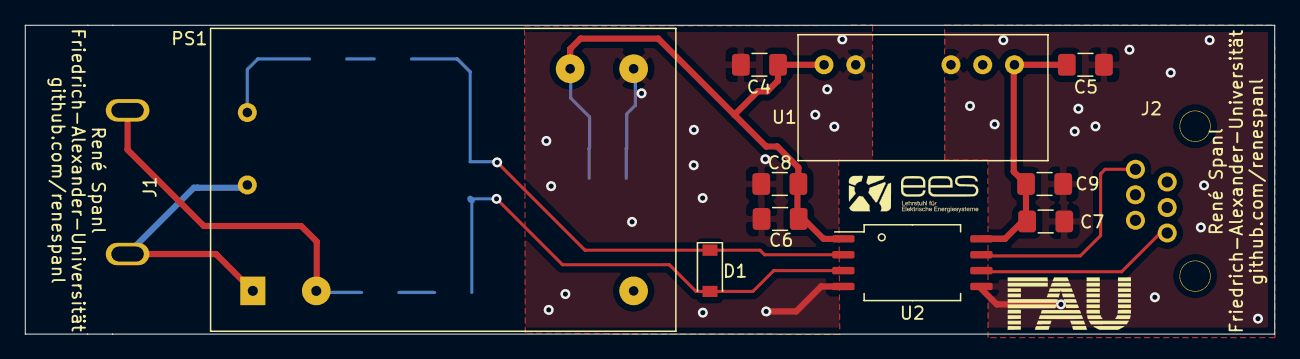
[picture p12: board IsolationBarrier.kicad_pcb from above]

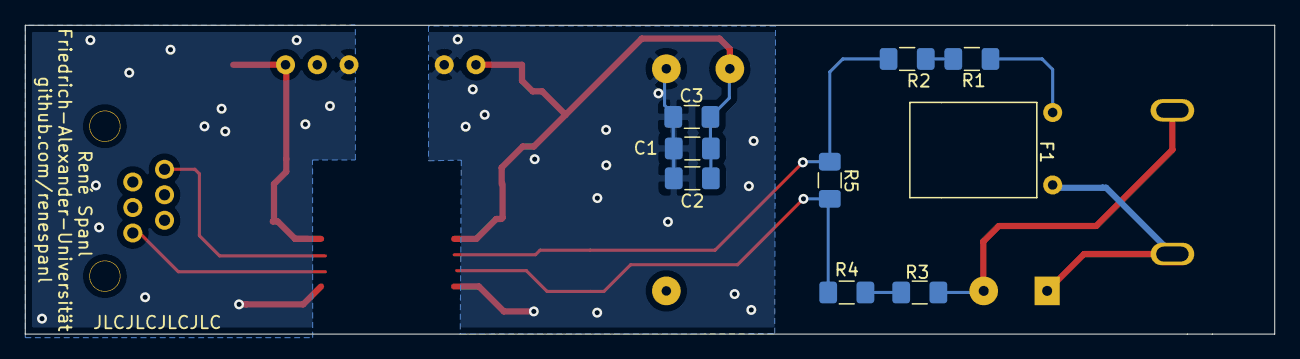
[picture p13: board IsolationBarrier.kicad_pcb from below]

Board: 2 copper layers, 100.0 x 24.7 mm, 21 parts (9 on the bottom side), 13 nets.
