ReneSpanl/GridFrequency/(commit log)

2021-05-28 First Comment. PCB missing
    [AD_Conversion.sch, BOM.xlsx, ESP32_sub.sch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]
2021-05-28 Final Commit
    [PCB-B_Cu.gbr, PCB-B_Mask.gbr, PCB-B_Paste.gbr, PCB-B_SilkS.gbr, PCB-Edge_Cuts.gbr, PCB-F_Cu.gbr, PCB-F_Mask.gbr, PCB-F_Paste.gbr]
